Jeff-Birt/Backpack/Images/IMG_9679.JPG

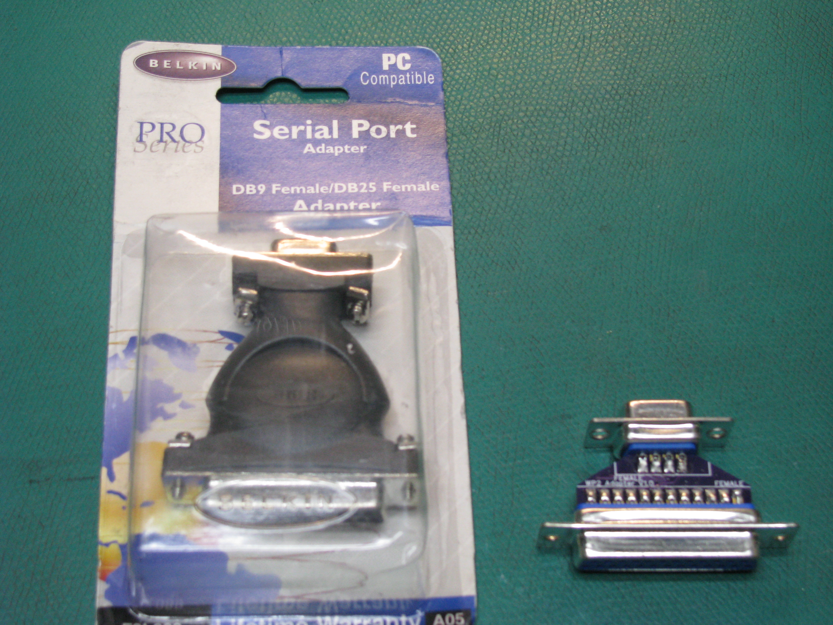
Images/IMG_9679.JPG
