Jeff-Birt/Backpack/Images/IMG_9678.JPG

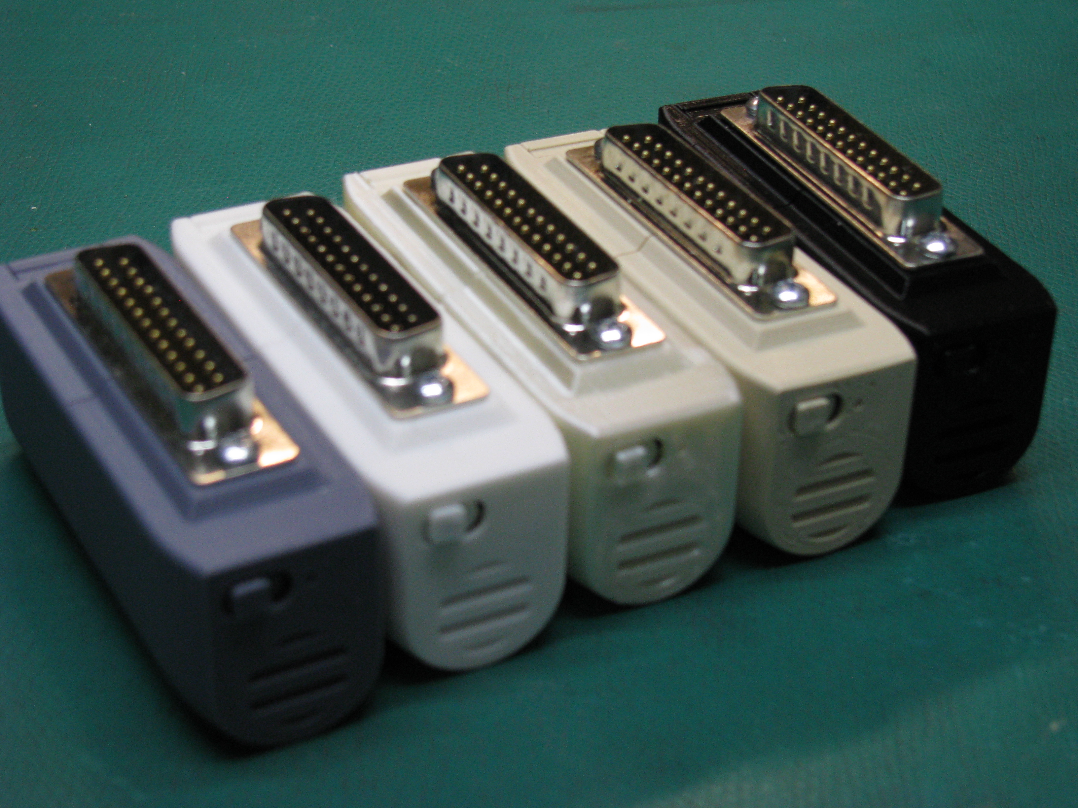
Images/IMG_9678.JPG
