Jeff-Birt/Backpack/README.md

# Backpack Drive

Documentation, firmware, SD card files for Mini TPDD 'Backpack' drive.

## Quick-Start video

https://www.youtube.com/watch?v=3es0NLJmd2c
