Jeff-Birt/Backpack/Enclosure/README.md

# 3D Print files for Original Backpack enclsoure

V1     - Original version without 'swtich hat'
V2     - Addded a 'swtich hat' to make the power switch easier to operate
