Jeff-Birt/Backpack/bootstrap/README.md

# BOOT

This is the "stage-0" initial program loader that runs during the
"Quick Start" procedure. It determines which type of machine it's
running on and then triggers the stage-1 loader for that machine
(as defined in the Backpack Drive `boot` settings).
