Jeff-Birt/Backpack/BPD Files/bootstrap/README.md

# Set of files for the uPDD
a uSD based storage device that mimics the Tandy Portable Disk Drive

## Pace holder
