Jeff-Birt/Backpack/Enclosure/V2/Right.stl

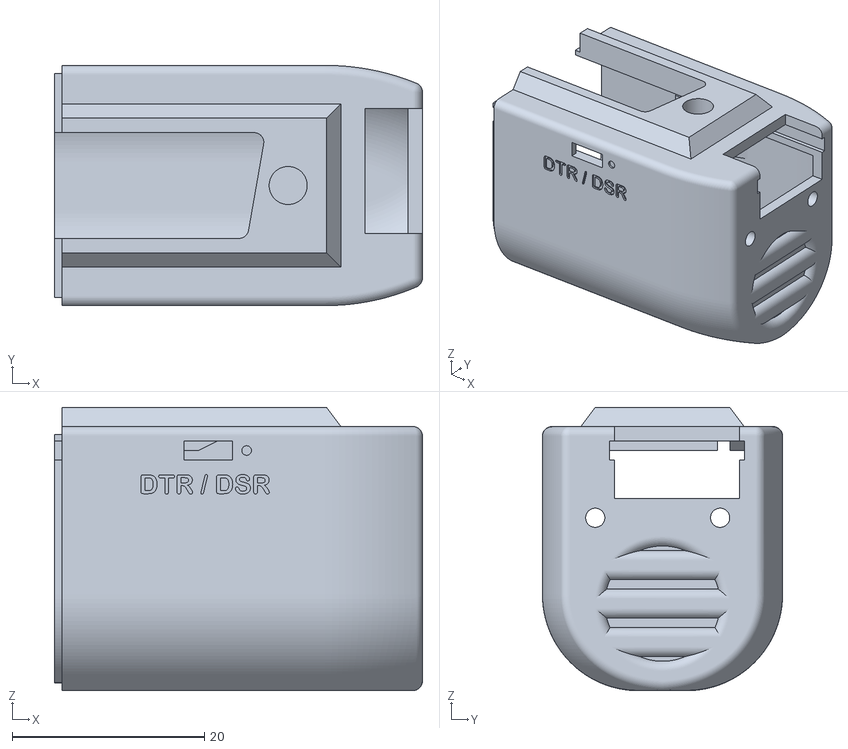
[picture p5: CAD file, 2021-06-11]
Enclosure/V2/Right.stl
38.3 x 25.0 x 29.5
