Jeff-Birt/Backpack/Enclosure/V2/Switch_Hat.stl

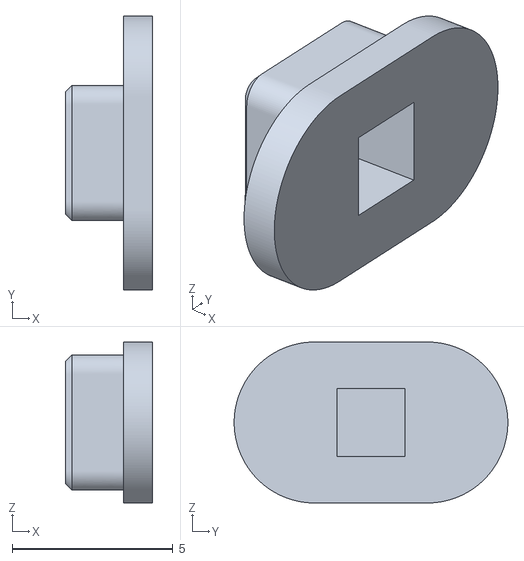
[picture p6: CAD file, 2021-06-11]
Enclosure/V2/Switch_Hat.stl
2.70 x 8.50 x 5.00
