Jeff-Birt/Backpack/Enclosure/V2/uSD_Door.stl

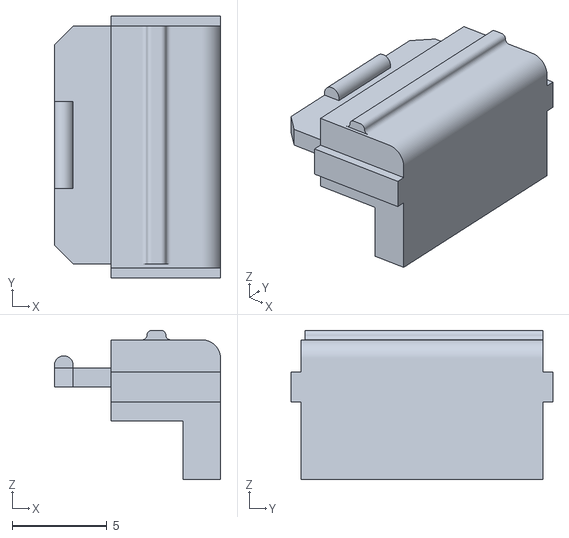
[picture p7: CAD file, 2021-06-11]
Enclosure/V2/uSD_Door.stl
8.80 x 13.9 x 7.90
