Jeff-Birt/Backpack/Enclosure/V1/Right.stl

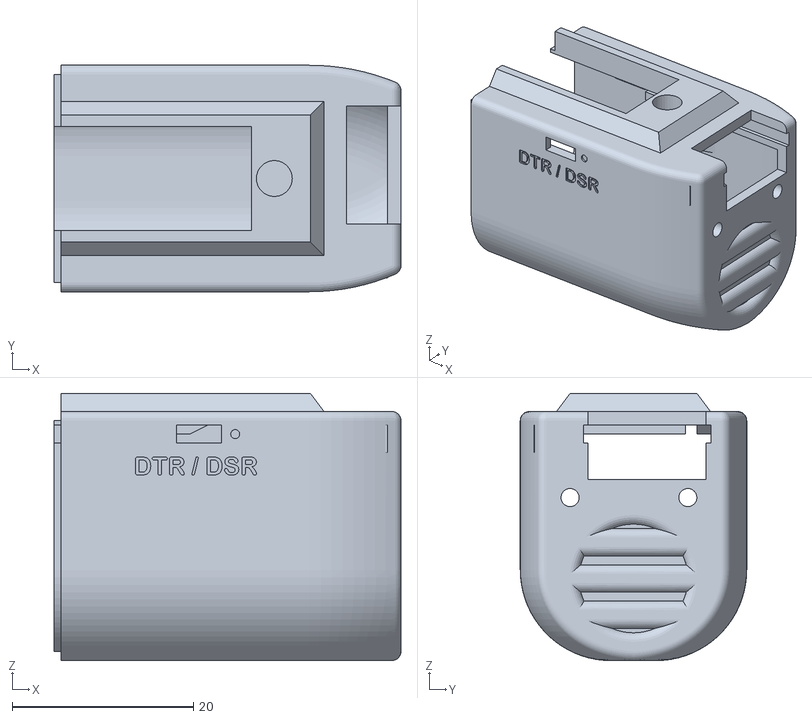
[picture p8: CAD file, 2021-06-10, an earlier design]
Enclosure/V1/Right.stl
38.3 x 25.0 x 29.5
