Jeff-Birt/Backpack/(list of files, cad)

Other CAD files:
Enclosure/V2/Left.stl
Enclosure/V1/Left.stl
Enclosure/V1/uSD_Door.stl
