Jeff-Birt/Backpack/SD_builder/README.md

# SD zip builder

This script builds a release zip of the required files for the 'sector0'
directory on the Backpack Drive

## Components

 * BOOT (from 'bootstrap' directory)
 * TS-DOS.xxx (from https://github.com/bkw777/dlplus/tree/master/clients)
 * TEENY.xxx (from https://github.com/bkw777/dlplus/tree/master/clients)
 * help/... (from 'helpfiles' directory)
 
## Bootstrap

This is the level-0 bootstrap code that runs on the laptop during the
initial `RUN "COM:` step.
