Jeff-Birt/Backpack/(commit log)

2021-06-10 Tested stage-0 bootstrap
2021-06-10 3D print files for the case
    [Left.stl, Right.stl, uSD_Door.stl]
2021-06-11 Updated enclosure files to V2 which is first production release
    [Left.stl, Right.stl, Switch_Hat.stl, uSD_Door.stl]
2022-11-07 Added new files
    [Left.stl, Right.stl, Switch_Hat.stl, uSD_Door.stl]
2022-11-07 Removed old files
    [Left.stl, Right.stl, Switch_Hat.stl, uSD_Door.stl]
2022-11-13 fixing screw up
2023-12-08 Fixed typp
    [Left.stl, Right.stl, Switch_Hat.stl, uSD_Door.stl]
2024-08-09 Updated help files
    [Left.stl, Right.stl, Switch_Hat.stl, uSD_Door.stl]
